okamoto-ryo/fm-1/README.md

# fm-1
DIY FM synthesizer

## Overview
<a href="https://okamoto-ryo.github.io/fm-1.html" target="_blank">FM-1</a>

## Requirements
- ARM KEIL uVision 5.0

## やること
- サイン波をsvfで生成するようにする
- ディスプレイのグラフィックを改善
- エンベロープのasymp化
- パラメーター追加
  - LFOの種類
