okamoto-ryo/fm-1/(list of files, cad)

Other CAD files:
hardware/case/minipiano.ipt
