okamoto-ryo/fm-1/hardware/pcb/main_oled.brd

## EAGLE design hardware/pcb/main_oled.brd (2023-06-15)

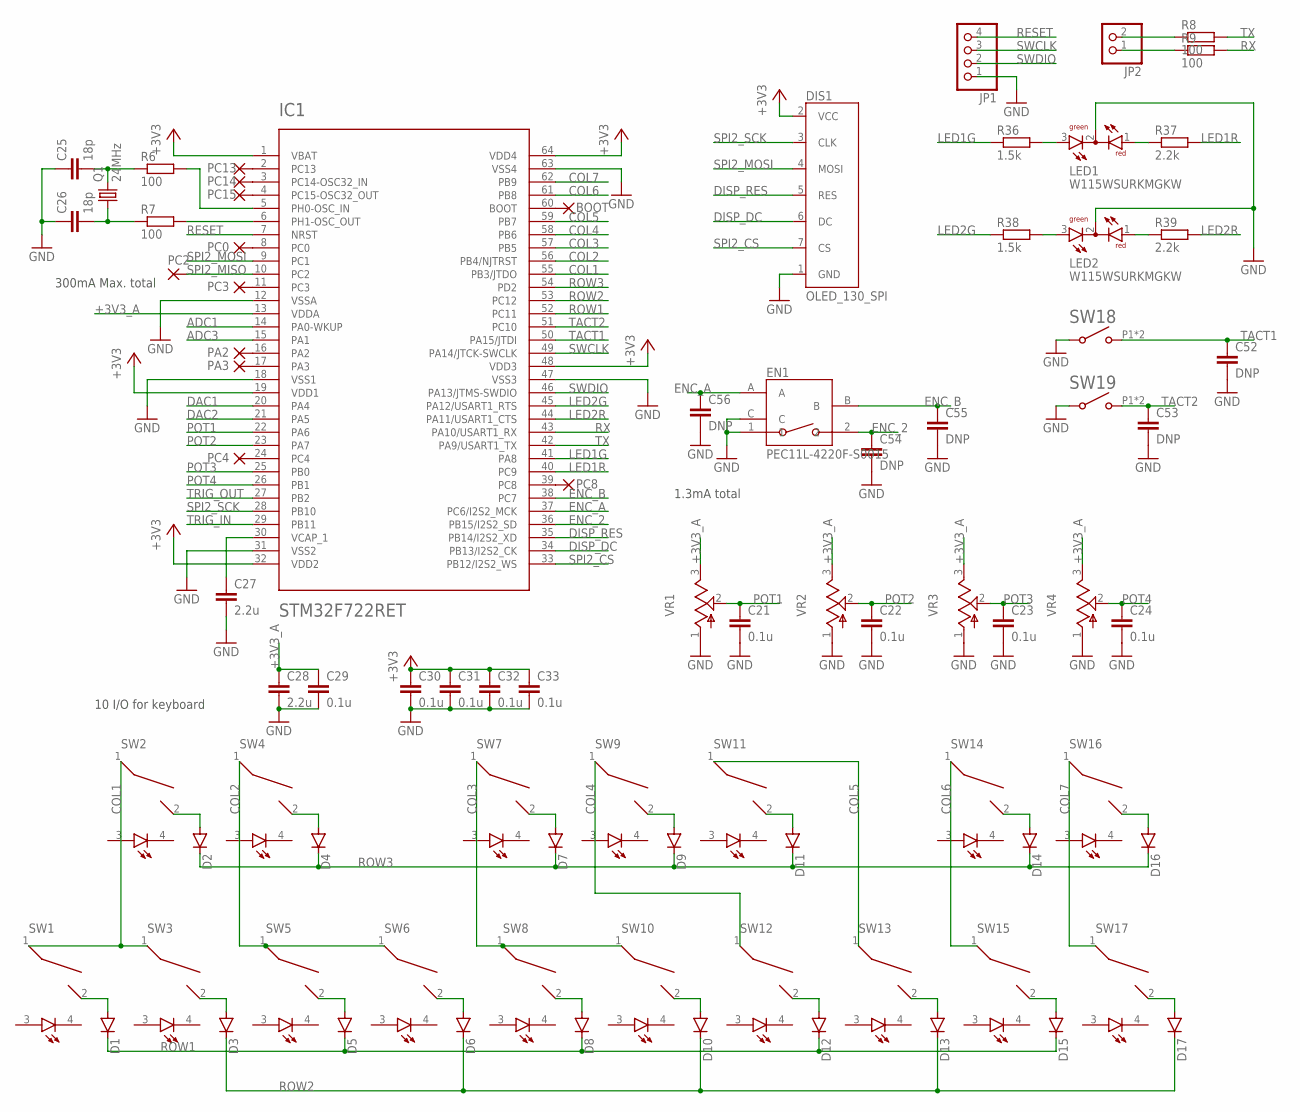
[picture p1: schematic main_oled.sch, sheet 1]

Parts:
BOOT: WIREPAD1,6/0,9; 1,6/0,9
C21, C22, C23, C24, C29, C30, C31, C32, C33: 0.1u; C0603
C25, C26: 18p; C0603
C27, C28: 2.2u; C0805
C52, C53, C54, C55, C56: DNP; C0603
D1, D2, D3, D4, D5, D6, D7, D8, D9, D10, D11, D12, D13, D14, D15, D16, D17: DIODE-SOD123; SOD123
DIS1: OLED_130_SPI
EN1: PEC11L-4220F-S0015
IC1: STM32F722RET; TQFP64
JP1: PINHD-1X4; 1X04
JP2: PINHD-1X2; 1X02
LED1, LED2: W115WSURKMGKW
PA2, PA3: WIREPAD1,6/0,9; 1,6/0,9
PC0, PC2, PC3, PC4, PC8, PC13, PC14, PC15: WIREPAD1,6/0,9; 1,6/0,9
Q1: 24MHz; HC49UP
R6, R7, R8, R9: 100; R0603
R36, R38: 1.5k; R0603
R37, R39: 2.2k; R0603
SW1, SW2, SW3, SW4, SW5, SW6, SW7, SW8, SW9, SW10, SW11, SW12, SW13, SW14, SW15, SW16, SW17: CHERRY_MX_LED_WITH_FIXING_PINS; MX1A-XX[R/G/Y]W
SW18, SW19: TACT_TH
VR1, VR2, VR3, VR4: 9MM_V

Connections:
+3V3: C30.1, C31.1, C32.1, C33.1, DIS1.2 (VCC), IC1.1 (VBAT), IC1.19 (VDD1), IC1.32 (VDD2), IC1.48 (VDD3), IC1.64 (VDD4); also elsewhere on the board
+3V3_A: C28.1, C29.1, IC1.13 (VDDA), VR1.3, VR2.3, VR3.3, VR4.3; also elsewhere on the board
ADC1: IC1.14 (PA0-WKUP); also elsewhere on the board
ADC3: IC1.15 (PA1); also elsewhere on the board
COL1: IC1.55 (PB3/JTDO), SW1.1, SW2.1, SW3.1
COL2: IC1.56 (PB4/NJTRST), SW4.1, SW5.1, SW6.1
COL3: IC1.57 (PB5), SW7.1, SW8.1, SW10.1
COL4: IC1.58 (PB6), SW9.1, SW12.1
COL5: IC1.59 (PB7), SW11.1, SW13.1
COL6: IC1.61 (PB8), SW14.1, SW15.1
COL7: IC1.62 (PB9), SW16.1, SW17.1
DAC1: IC1.20 (PA4); also elsewhere on the board
DAC2: IC1.21 (PA5); also elsewhere on the board
DISP_DC: DIS1.6 (DC), IC1.34 (PB13/I2S2_CK)
DISP_RES: DIS1.5 (RES), IC1.35 (PB14/I2S2_XD)
ENC_2: C54.1, EN1.2, IC1.36 (PB15/I2S2_SD)
ENC_A: C56.1, EN1.A, IC1.37 (PC6/I2S2_MCK)
ENC_B: C55.1, EN1.B, IC1.38 (PC7)
GND: C21.2, C22.2, C23.2, C24.2, C25.1, C26.1, C27.2, C28.2, C29.2, C30.2, C31.2, C32.2, C33.2, C52.2, C53.2, C54.2, C55.2, C56.2, DIS1.1 (GND), EN1.1, EN1.C, IC1.12 (VSSA), IC1.18 (VSS1), IC1.31 (VSS2), IC1.47 (VSS3), IC1.63 (VSS4), JP1.1, LED1.2 (C), LED2.2 (C), SW18.P3 (2), SW18.P4 (2), SW19.P3 (2), SW19.P4 (2), VR1.1, VR2.1, VR3.1, VR4.1; also elsewhere on the board
LED1G: IC1.41 (PA8), R36.1
LED1R: IC1.40 (PC9), R37.2
LED2G: IC1.45 (PA12/USART1_RTS), R38.1
LED2R: IC1.44 (PA11/USART1_CTS), R39.2
unnamed: LED1.3 (AG), R36.2
unnamed: LED1.1 (AR), R37.1
unnamed: LED2.3 (AG), R38.2
unnamed: LED2.1 (AR), R39.1
unnamed: IC1.2 (PC13), PC13.1
unnamed: IC1.3 (PC14-OSC32_IN), PC14.1
unnamed: IC1.4 (PC15-OSC32_OUT), PC15.1
unnamed: IC1.8 (PC0), PC0.1
unnamed: IC1.11 (PC3), PC3.1
unnamed: D1.A, SW1.2
unnamed: D2.A, SW2.2
unnamed: D3.A, SW3.2
unnamed: D4.A, SW4.2
unnamed: D5.A, SW5.2
unnamed: D6.A, SW6.2
unnamed: D7.A, SW7.2
unnamed: D8.A, SW8.2
unnamed: D9.A, SW9.2
unnamed: D10.A, SW10.2
unnamed: D11.A, SW11.2
unnamed: D12.A, SW12.2
unnamed: D13.A, SW13.2
unnamed: D14.A, SW14.2
unnamed: D15.A, SW15.2
unnamed: D16.A, SW16.2
unnamed: D17.A, SW17.2
unnamed: IC1.16 (PA2), PA2.1
unnamed: JP2.1, R9.1
unnamed: JP2.2, R8.1
unnamed: IC1.5 (PH0-OSC_IN), R6.2
unnamed: IC1.6 (PH1-OSC_OUT), R7.2
unnamed: C25.2, Q1.2, R6.1
unnamed: C26.2, Q1.1, R7.1
unnamed: C27.1, IC1.30 (VCAP_1)
unnamed: IC1.17 (PA3), PA3.1
unnamed: IC1.24 (PC4), PC4.1
unnamed: IC1.39 (PC8), PC8.1
unnamed: BOOT.1, IC1.60 (BOOT)
POT1: C21.1, IC1.22 (PA6), VR1.2
POT2: C22.1, IC1.23 (PA7), VR2.2
POT3: C23.1, IC1.25 (PB0), VR3.2
POT4: C24.1, IC1.26 (PB1), VR4.2
RESET: IC1.7 (NRST), JP1.4
ROW1: D1.C, D5.C, D8.C, D12.C, D15.C, IC1.52 (PC11)
ROW2: D3.C, D6.C, D10.C, D13.C, D17.C, IC1.53 (PC12)
ROW3: D2.C, D4.C, D7.C, D9.C, D11.C, D14.C, D16.C, IC1.54 (PD2)
RX: IC1.43 (PA10/USART1_RX), R9.2
SPI2_CS: DIS1.7 (CS), IC1.33 (PB12/I2S2_WS)
SPI2_MISO: IC1.10 (PC2), PC2.1
SPI2_MOSI: DIS1.4 (MOSI), IC1.9 (PC1)
SPI2_SCK: DIS1.3 (CLK), IC1.28 (PB10)
SWCLK: IC1.49 (PA14/JTCK-SWCLK), JP1.3
SWDIO: IC1.46 (PA13/JTMS-SWDIO), JP1.2
TACT1: C52.1, IC1.50 (PA15/JTDI), SW18.P1 (1), SW18.P2 (1)
TACT2: C53.1, IC1.51 (PC10), SW19.P1 (1), SW19.P2 (1)
TRIG_IN: IC1.29 (PB11); also elsewhere on the board
TRIG_OUT: IC1.27 (PB2); also elsewhere on the board
TX: IC1.42 (PA9/USART1_TX), R8.2

Notes on the sheet:
10 I/O for keyboard
300mA Max. total
1.3mA total

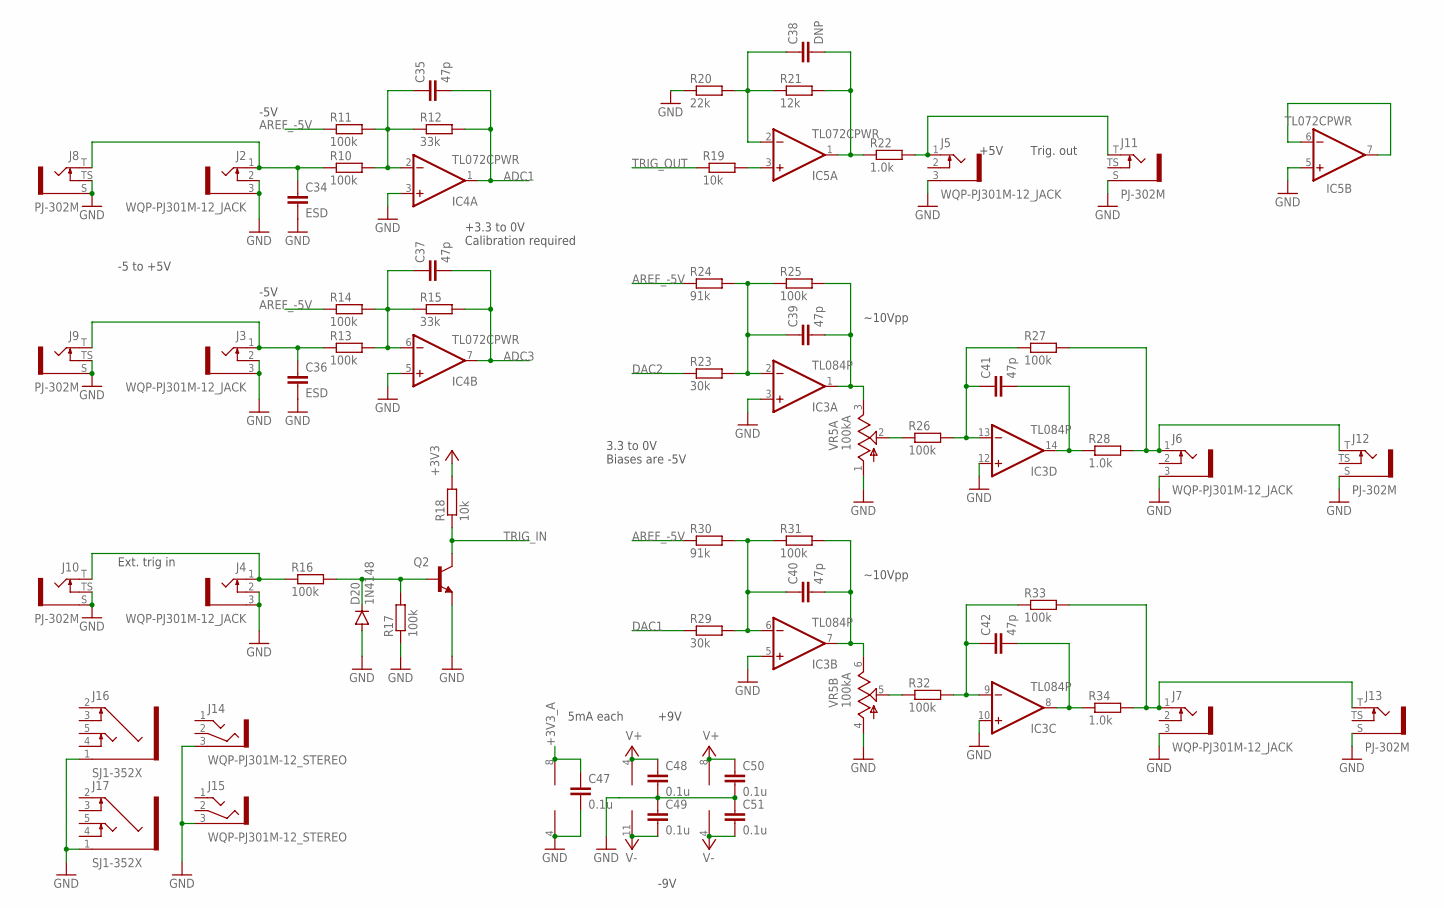
[picture p2: schematic main_oled.sch, sheet 2]

Parts:
C34, C36: ESD; C0603
C35, C37, C39, C40, C41, C42: 47p; C0603
C38: DNP; C0603
C47, C48, C49, C50, C51: 0.1u; C0603
D20: 1N4148; SOD123
IC3: TL084P; TSSOP14
IC4, IC5: TL072CPWR; TSSOP8
J2, J3, J4, J5, J6, J7: WQP-PJ301M-12_JACK
J8, J9, J10, J11, J12, J13: PJ-302M
J14, J15: WQP-PJ301M-12_STEREO; WQP-PJ301M-12_JACK
J16, J17: SJ1-352X
Q2: MMBT3904LT1-NPN-SOT23-BEC; SOT23-BEC
R10, R11, R13, R14, R16, R17, R25, R26, R27, R31, R32, R33: 100k; R0603
R12, R15: 33k; R0603
R18, R19: 10k; R0603
R20: 22k; R0603
R21: 12k; R0603
R22, R28, R34: 1.0k; R0603
R23, R29: 30k; R0603
R24, R30: 91k; R0603
VR5: 100kA; 9MM_V_DUAL

Connections:
+3V3: R18.2; also elsewhere on the board
+3V3_A: C47.1, IC4.8 (V+); also elsewhere on the board
ADC1: C35.2, IC4.1 (OUT), R12.2; also elsewhere on the board
ADC3: C37.2, IC4.7 (OUT), R15.2; also elsewhere on the board
AREF_-5V: R11.1, R14.1, R24.1, R30.1; also elsewhere on the board
DAC1: R29.1; also elsewhere on the board
DAC2: R23.1; also elsewhere on the board
GND: C34.2, C36.2, C47.2, C48.2, C49.1, C50.2, C51.1, D20.A, IC3.3 (+IN), IC3.5 (+IN), IC3.10 (+IN), IC3.12 (+IN), IC4.3 (+IN), IC4.4 (V-), IC4.5 (+IN), IC5.5 (+IN), J2.2 (3), J2.3 (1), J3.2 (3), J3.3 (1), J4.2 (3), J4.3 (1), J5.3 (1), J6.3 (1), J7.3 (1), J8.S (1), J8.TS (3), J9.S (1), J9.TS (3), J10.S (1), J10.TS (3), J11.S (1), J12.S (1), J13.S (1), J14.3 (1), J15.3 (1), J16.1 (S), J17.1 (S), Q2.E, R17.1, R20.1, VR5.1, VR5.4 (1); also elsewhere on the board
unnamed: C34.1, J2.1 (2), J8.T (2), R10.1
unnamed: C35.1, IC4.2 (-IN), R10.2, R11.2, R12.1
unnamed: J4.1 (2), J10.T (2), R16.1
unnamed: C36.1, J3.1 (2), J9.T (2), R13.1
unnamed: C37.1, IC4.6 (-IN), R13.2, R14.2, R15.1
unnamed: D20.C, Q2.B, R16.2, R17.2
unnamed: R26.1, VR5.2
unnamed: C39.1, IC3.2 (-IN), R23.2, R24.2, R25.1
unnamed: J6.1 (2), J12.T (2), R27.2, R28.2
unnamed: C41.1, IC3.13 (-IN), R26.2, R27.1
unnamed: C40.1, IC3.6 (-IN), R29.2, R30.2, R31.1
unnamed: C41.2, IC3.14 (OUT), R28.1
unnamed: R32.1, VR5.5 (2)
unnamed: C38.2, IC5.1 (OUT), R21.2, R22.1
unnamed: C39.2, IC3.1 (OUT), R25.2, VR5.3
unnamed: C40.2, IC3.7 (OUT), R31.2, VR5.6 (3)
unnamed: C42.1, IC3.9 (-IN), R32.2, R33.1
unnamed: C42.2, IC3.8 (OUT), R34.1
unnamed: J7.1 (2), J13.T (2), R33.2, R34.2
unnamed: C38.1, IC5.2 (-IN), R20.2, R21.1
unnamed: IC5.3 (+IN), R19.2
unnamed: J5.1 (2), J11.T (2), R22.2
unnamed: IC5.6 (-IN), IC5.7 (OUT)
TRIG_IN: Q2.C, R18.1; also elsewhere on the board
TRIG_OUT: R19.1; also elsewhere on the board
V+: C48.1, C50.1, IC3.4 (V+), IC5.8 (V+); also elsewhere on the board
V-: C49.2, C51.2, IC3.11 (V-), IC5.4 (V-); also elsewhere on the board

Notes on the sheet:
5mA each
Ext. trig in
Trig. out
3.3 to 0V Biases are -5V
+5V
-5 to +5V
+3.3 to 0V Calibration required
-5V
~10Vpp
-9V
+9V

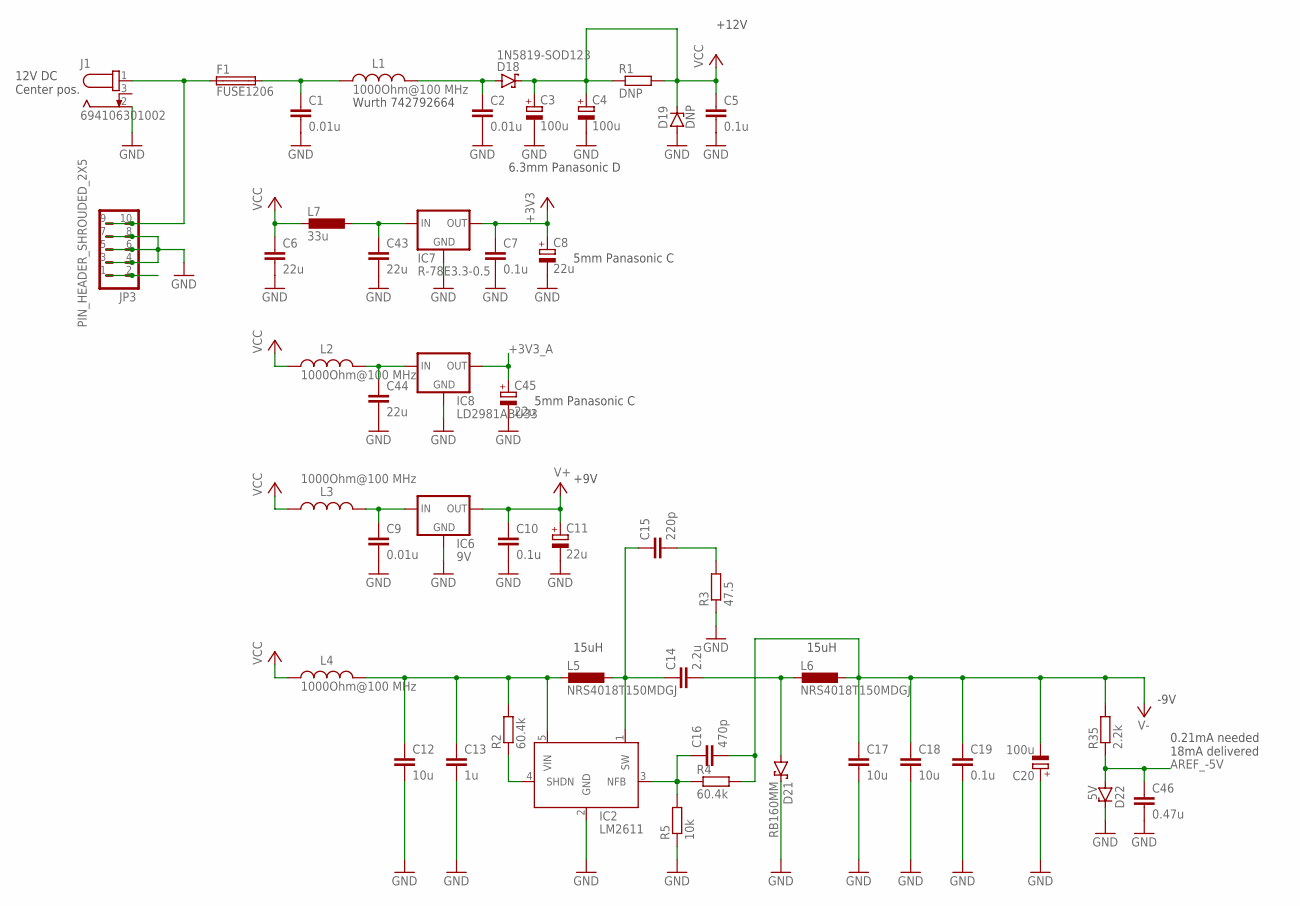
[picture p3: schematic main_oled.sch, sheet 3]

Parts:
C1, C2, C9: 0.01u; C0603
C3, C4, C20: 100u; PANASONIC_D
C5, C7, C10, C19: 0.1u; C0603
C6, C43, C44: 22u; C1206
C8, C11, C45: 22u; PANASONIC_C
C12, C17, C18: 10u; C0805
C13: 1u; C0805
C14: 2.2u; C0805
C15: 220p; C0603
C16: 470p; C0603
C46: 0.47u; C0603
D18: 1N5819-SOD123; SOD123
D19: DNP; SOT23
D21: RB160MM; SOD123
D22: 5V; SOD123
F1: FUSE1206; R1206
IC2: LM2611; SOT23-5
IC6: 9V; TO252-3
IC7: R-78E3.3-0.5; R-78E
IC8: LD2981ABU33; SOT89R
J1: 694106301002
JP3: PIN_HEADER_SHROUDED_2X5
L1, L2, L3, L4: 1000Ohm@100 MHz; WE-CBF_0603(W=2.2)
L5, L6: NRS4018T150MDGJ; NR40XX
L7: 33u; L2012C
R1: DNP; R1210
R2, R4: 60.4k; R0603
R3: 47.5; R0603
R5: 10k; R0603
R35: 2.2k; R0603

Connections:
+3V3: C7.1, C8.+, IC7.3 (OUT); also elsewhere on the board
+3V3_A: C45.+, IC8.2 (OUT); also elsewhere on the board
AREF_-5V: C46.1, D22.A, R35.1; also elsewhere on the board
GND: C1.2, C2.2, C3.-, C4.-, C5.2, C6.2, C7.2, C8.-, C9.2, C10.2, C11.-, C12.2, C13.2, C17.2, C18.2, C19.2, C20.+, C43.2, C44.2, C45.-, C46.2, D19.1 (A), D21.C, D22.C, IC2.2 (GND), IC6.GND, IC7.2 (GND), IC8.3 (GND), IC8.4 (GND), J1.2, JP3.3, JP3.4, JP3.5, JP3.6, JP3.7, JP3.8, R3.1, R5.1; also elsewhere on the board
unnamed: F1.1, J1.1, JP3.9, JP3.10
unnamed: C2.1, D18.A, L1.2
unnamed: C1.1, F1.2, L1.1
unnamed: C12.1, C13.1, IC2.5 (VIN), L4.2, L5.2, R2.2
unnamed: C14.1, C15.1, IC2.1 (SW), L5.1
unnamed: IC2.4 (SHDN), R2.1
unnamed: C15.2, R3.2
unnamed: C16.1, IC2.3 (NFB), R4.1, R5.2
unnamed: C14.2, D21.A, L6.2
unnamed: C9.1, IC6.IN, L3.2
unnamed: C43.1, IC7.1 (IN), L7.1
unnamed: C44.1, IC8.1 (IN), L2.2
unnamed: JP3.1, JP3.2
V+: C10.1, C11.+, IC6.OUT; also elsewhere on the board
V-: C16.2, C17.1, C18.1, C19.1, C20.-, L6.1, R4.2, R35.2; also elsewhere on the board
VCC: C3.+, C4.+, C5.1, C6.1, D18.C, D19.3 (C), L2.1, L3.1, L4.1, L7.2, R1.1, R1.2

Notes on the sheet:
12V DC Center pos.
Wurth 742792664
6.3mm Panasonic D
+12V
-9V
15uH
+9V
5mm Panasonic C
0.21mA needed 18mA delivered

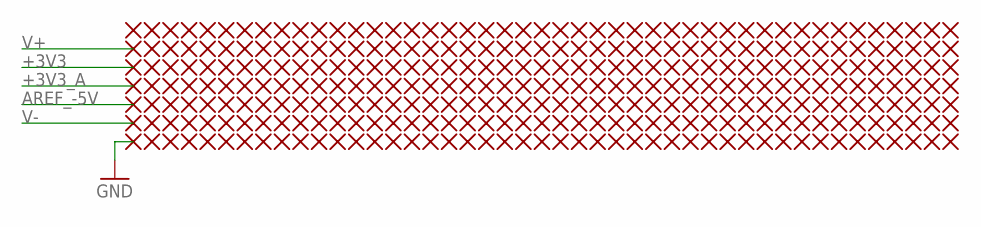
[picture p4: schematic main_oled.sch, sheet 4]

Parts:
P1, P2, P3, P4, P5, P6, P7, P8, P9, P10, P11, P12, P13, P14, P15, P16, P17, P18, P19, P20, P21, P22, P23, P24, P25, P26, P27, P28, P29, P30, P31, P32, P33, P34, P35, P36, P37, P38, P39, P40, P41, P42, P43, P44, P45, P46, P47, P48, P49, P50, P51, P52, P53, P54, P55, P56, P57, P58, P59, P60, P61, P62, P63, P64, P65, P66, P67, P68, P69, P70, P71, P72, P73, P74, P75, P76, P77, P78, P79, P80, P81, P82, P83, P84, P85, P86, P87, P88, P89, P90, P91, P92, P93, P94, P95, P96, P97, P98, P99, P100, P101, P102, P103, P104, P105, P106, P107, P108, P109, P110, P111, P112, P113, P114, P115, P116, P117, P118, P119, P120, P121, P122, P123, P124, P125, P126, P127, P128, P129, P130, P131, P132, P133, P134, P135, P136, P137, P138, P139, P140, P141, P142, P143, P144, P145, P146, P147, P148, P149, P150, P151, P152, P153, P154, P155, P156, P157, P158, P159, P160, P161, P162, P163, P164, P165, P166, P167, P168, P169, P170, P171, P172, P173, P174, P175, P176, P177, P178, P179, P180, P181, P182, P183, P184, P185, P186, P187, P188, P189, P190, P191, P192, P193, P194, P195, P196, P197, P198, P199, P200, P201, P202, P203, P204, P205, P206, P207, P208, P209, P210, P211, P212, P213, P214, P215, P216, P217, P218, P219, P220, P221, P222, P223, P224, P225, P226, P227, P228, P229, P230, P231, P232, P233, P234, P235, P236, P237, P238, P239, P240, P241, P242, P243, P244, P245, P246, P247, P248, P249, P250, P251, P252, P253, P254, P255, P256, P257, P258, P259, P260, P261, P262, P263, P264, P265, P266, P267, P268, P269, P270, P271, P272, P273, P274, P275, P276, P277, P278, P279, P280, P281, P282, P283, P284, P285, P286, P287, P288, P289, P290, P291, P292, P293, P294, P295, P296, P297, P298, P299, P300, P301, P302, P303, P304, P305, P306, P307, P308, P309, P310, P311, P312, P313, P314, P315: PERF_2.54

Connections:
+3V3: P3.1; also elsewhere on the board
+3V3_A: P4.1; also elsewhere on the board
AREF_-5V: P5.1; also elsewhere on the board
GND: P7.1; also elsewhere on the board
V+: P2.1; also elsewhere on the board
V-: P6.1; also elsewhere on the board

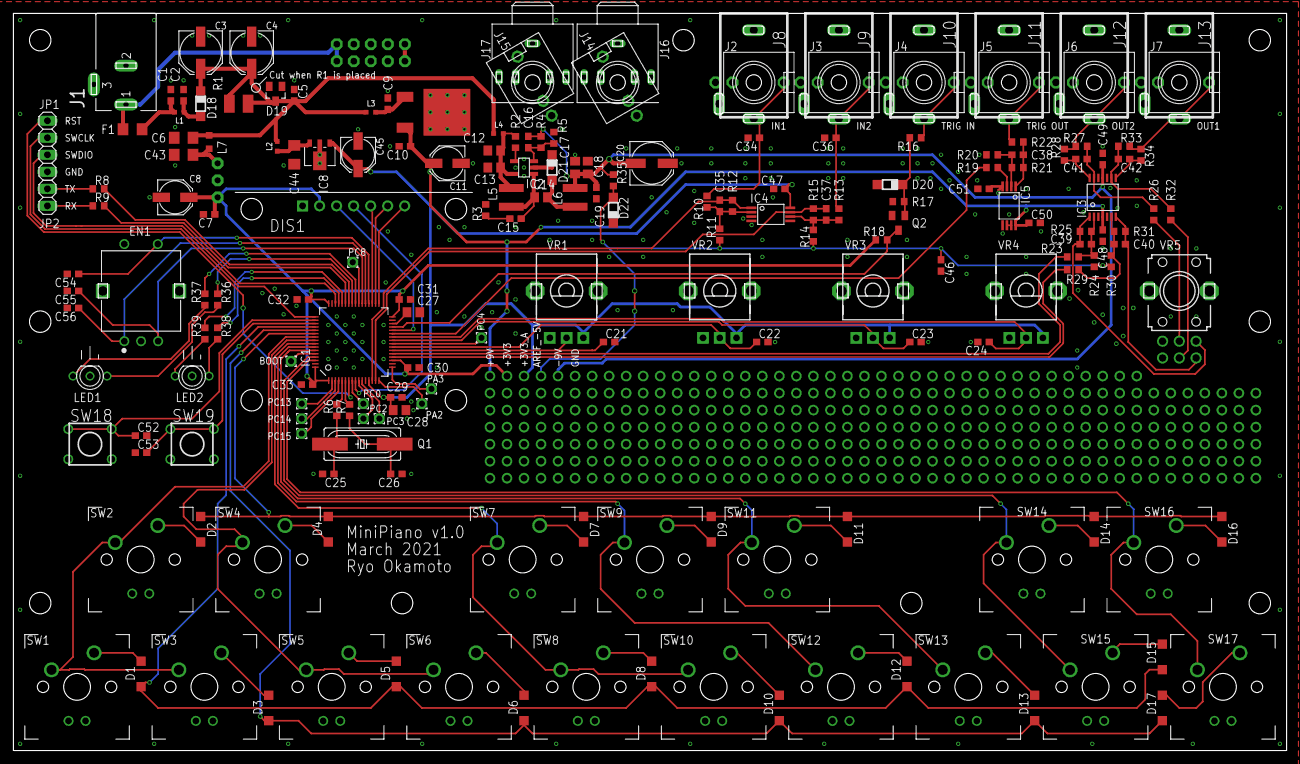
[picture p5: board main_oled.brd from above]

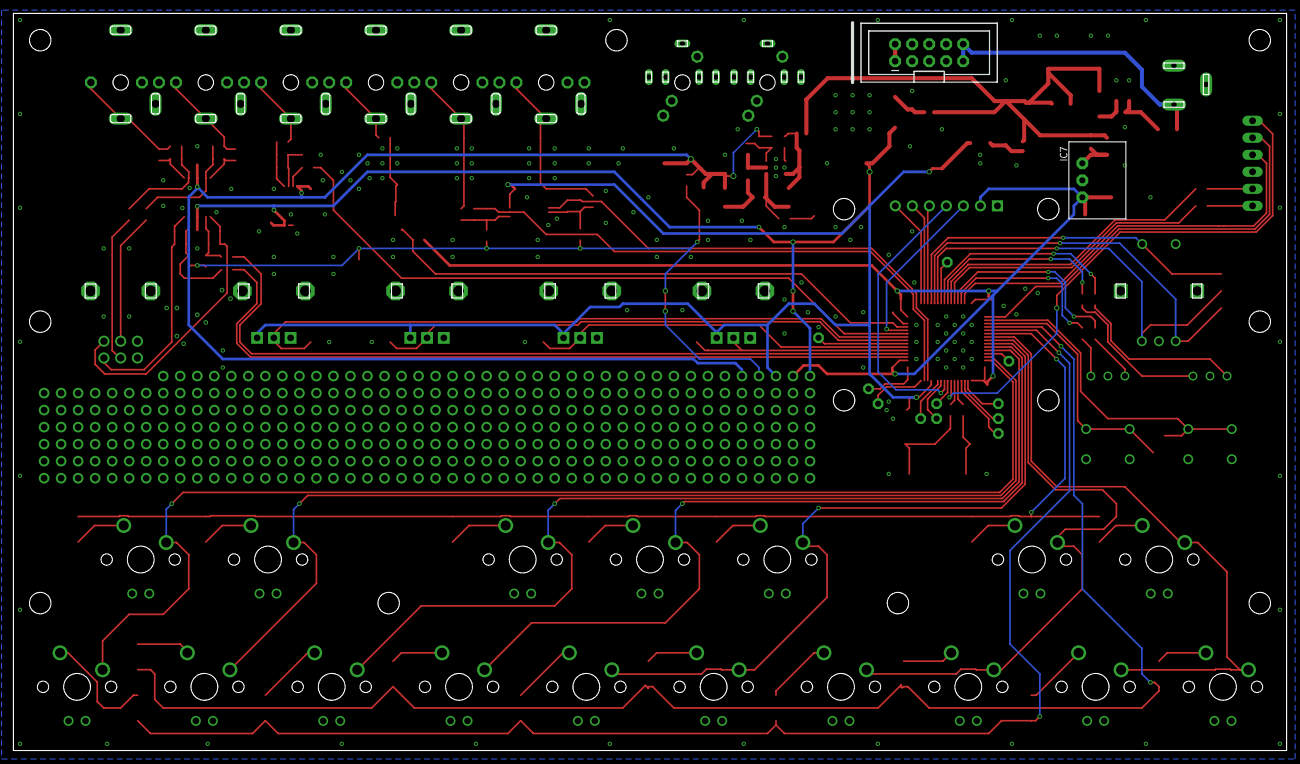
[picture p6: board main_oled.brd from below]

Board: 2 copper layers, 190.0 x 110.0 mm, 509 parts (2 on the bottom side), 121 nets.
