okamoto-ryo/fm-1/hardware/pcb/main.brd

## EAGLE design hardware/pcb/main.brd (2023-06-15)

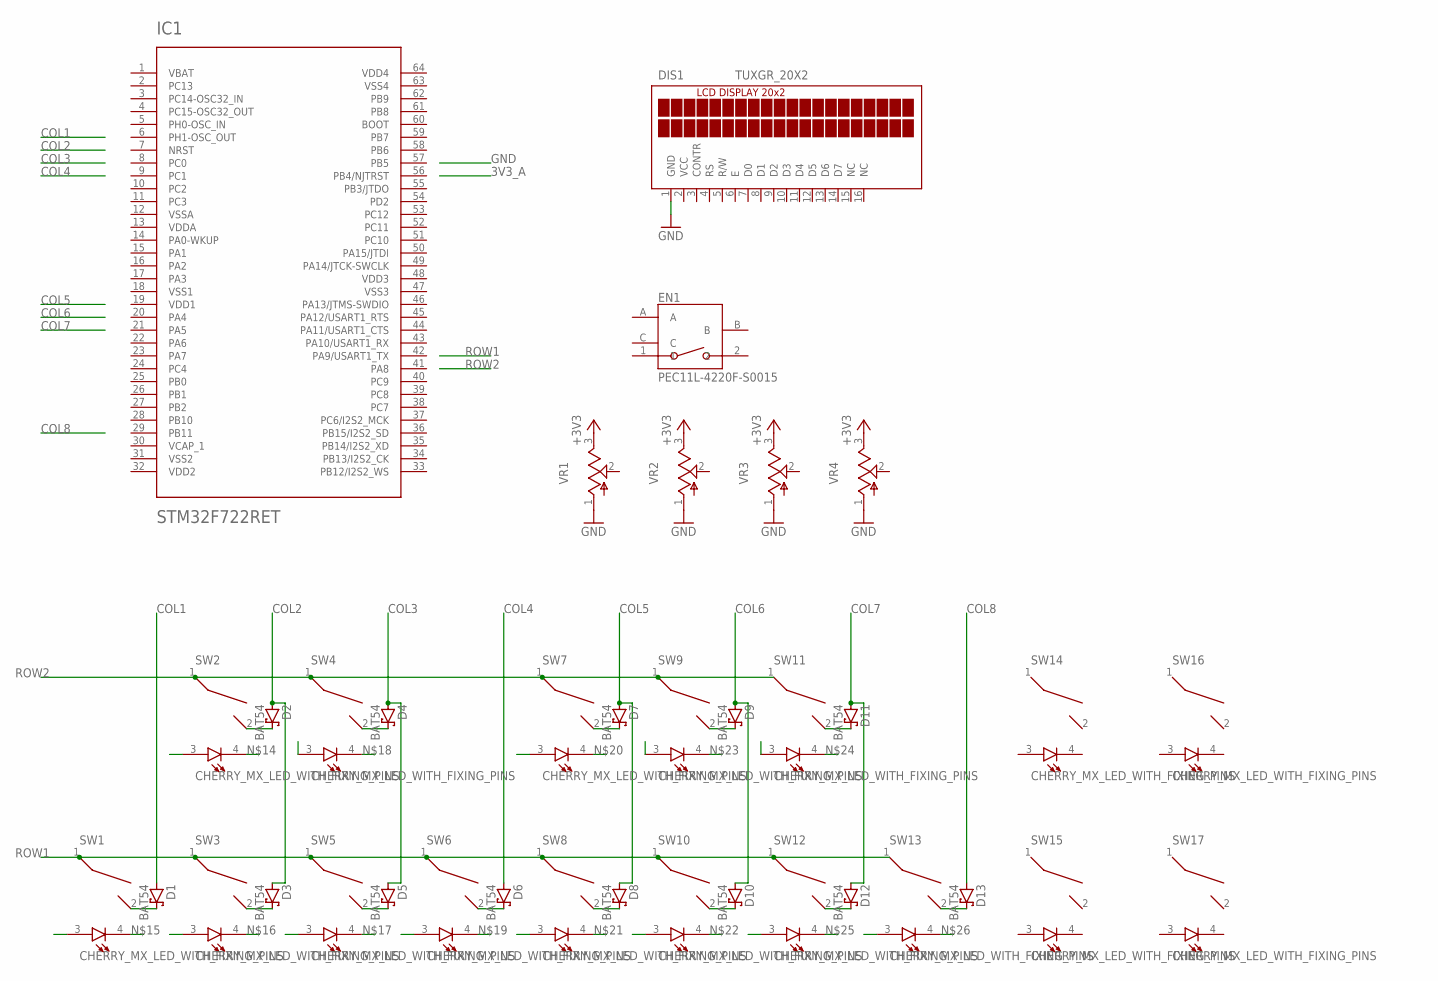
[picture p7: schematic main.sch, sheet 1]

Parts:
D1, D2, D3, D4, D5, D6, D7, D8, D9, D10, D11, D12, D13: BAT54; SOT23
DIS1: TUXGR_20X2
EN1: PEC11L-4220F-S0015
IC1: STM32F722RET; TQFP64
SW1, SW2, SW3, SW4, SW5, SW6, SW7, SW8, SW9, SW10, SW11, SW12, SW13, SW14, SW15, SW16, SW17: CHERRY_MX_LED_WITH_FIXING_PINS; MX1A-XX[R/G/Y]W
VR1, VR2, VR3, VR4: 9MM_V

Connections:
+3V3: VR1.3, VR2.3, VR3.3, VR4.3; also elsewhere on the board
COL1: D1.1 (A)
COL2: D2.1 (A), D3.1 (A)
COL3: D4.1 (A), D5.1 (A)
COL4: D6.1 (A)
COL5: D7.1 (A), D8.1 (A)
COL6: D9.1 (A), D10.1 (A)
COL7: D11.1 (A), D12.1 (A)
COL8: D13.1 (A)
GND: DIS1.1 (GND), VR1.1, VR2.1, VR3.1, VR4.1; also elsewhere on the board
unnamed: D2.3 (C), SW2.2
unnamed: D4.3 (C), SW4.2
unnamed: D7.3 (C), SW7.2
unnamed: D9.3 (C), SW9.2
unnamed: D11.3 (C), SW11.2
unnamed: D1.3 (C), SW1.2
unnamed: D3.3 (C), SW3.2
unnamed: D5.3 (C), SW5.2
unnamed: D6.3 (C), SW6.2
unnamed: D8.3 (C), SW8.2
unnamed: D10.3 (C), SW10.2
unnamed: D12.3 (C), SW12.2
unnamed: D13.3 (C), SW13.2
ROW1: SW1.1, SW3.1, SW5.1, SW6.1, SW8.1, SW10.1, SW12.1, SW13.1
ROW2: SW2.1, SW4.1, SW7.1, SW9.1, SW11.1
VCC: DIS1.2 (VCC); also elsewhere on the board

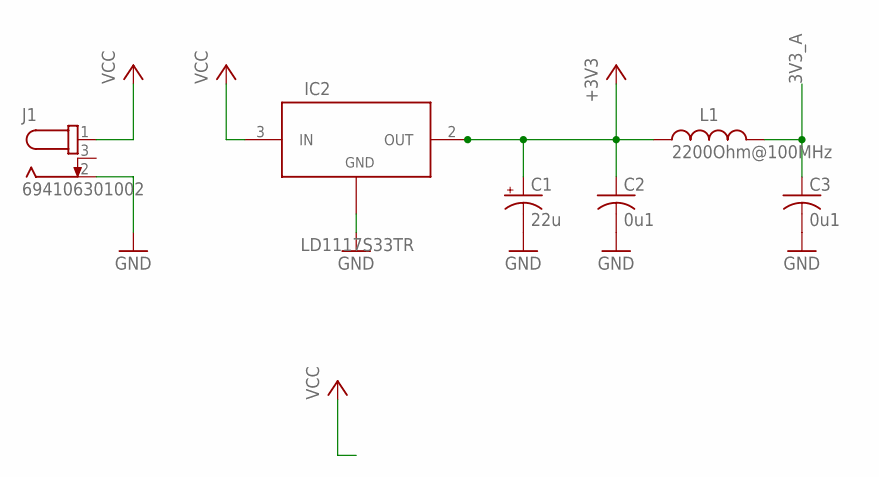
[picture p8: schematic main.sch, sheet 2]

Parts:
C1: 22u; PANASONIC_C
C2, C3: 0u1; C0603
IC2: LD1117S33TR; SOT-223
J1: 694106301002
L1: 2200Ohm@100MHz; WE-CBF_0603(W=2.2)

Connections:
3V3_A: C3.1, L1.2
+3V3: C1.+, C2.1, IC2.2 (OUT), IC2.4, L1.1; also elsewhere on the board
GND: C1.-, C2.2, C3.2, IC2.1 (ADJ/GND), J1.2; also elsewhere on the board
VCC: IC2.3 (IN), J1.1; also elsewhere on the board

Board: 2 copper layers, 43 parts (0 on the bottom side), 24 nets, no tracks yet.
