okamoto-ryo/fm-1/src/notes.c

#include "stm32f722xx.h"
#include <stdint.h>

extern const float equalTemp[] = {
	261.6256f,
	277.1826f,
	293.6648f,
	311.1270f,
	329.6276f,
	349.2282f,
	369.9944f,
	391.9954f,
	415.3047f,
	440.0000f,
	466.1638f,
	493.8833f
};
