okamoto-ryo/fm-1/(commit log)

2023-06-15 Add case laser cutting data
    [minipiano.ipt]
2023-06-15 Add eagle files
    [main.brd, main.sch, main_oled.brd, main_oled.csv, main_oled.sch, main_v20.brd, main_v20.sch]
2023-06-15 Sort files out
    [minipiano.ipt]
