okamoto-ryo/fm-1/(notices)

Notices in the files:
parts and their libraries:
Wurth_EMC Components_WE-CBF: Copyright: Würth Elektronik
